SeeedDocument/Seeeduino_LoRa/img/hardware_overview_2.png

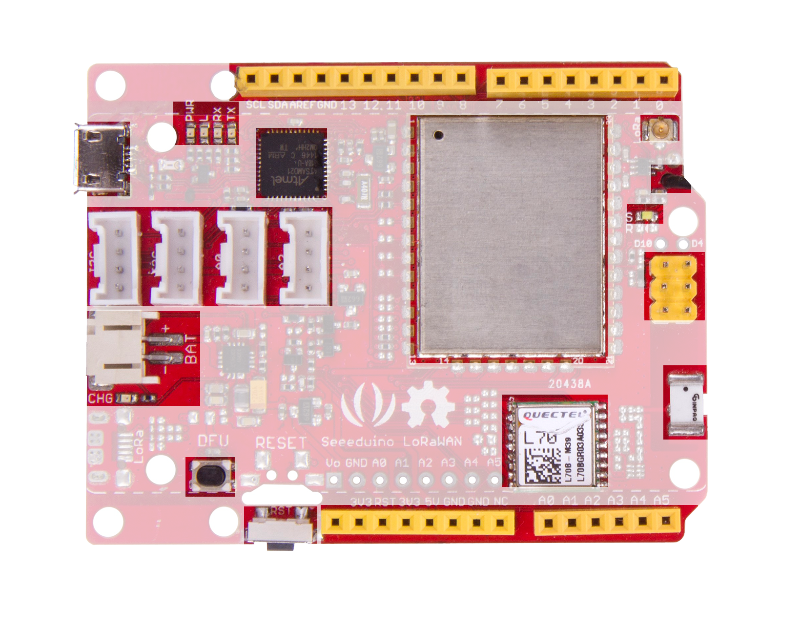
img/hardware_overview_2.png
