SeeedDocument/Seeeduino_LoRa/img/hardware_overview_1.png

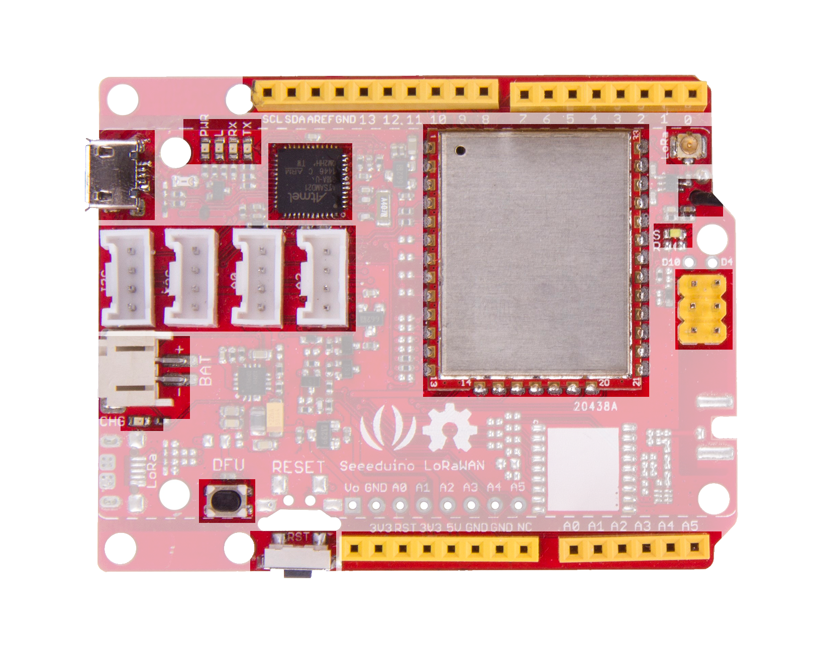
img/hardware_overview_1.png
