SeeedDocument/Seeeduino_LoRa/res/Seeeduino LoRaWAN GPS.pdf

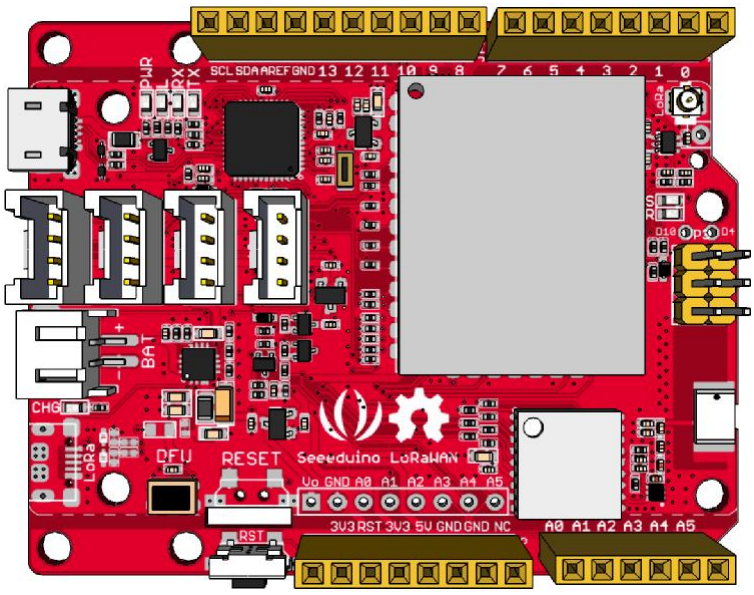
[picture p6: figure]
