SeeedDocument/Seeeduino_LoRa/img/11r.jpg

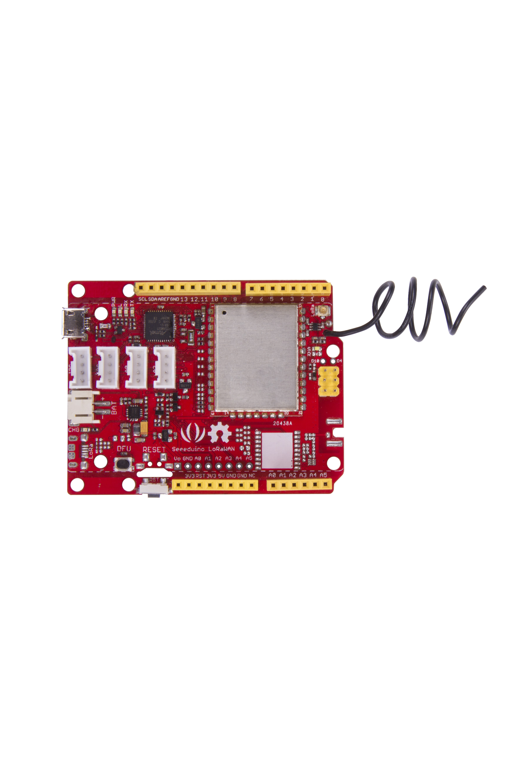
img/11r.jpg
