SeeedDocument/Seeeduino_LoRa/img/arduino.png

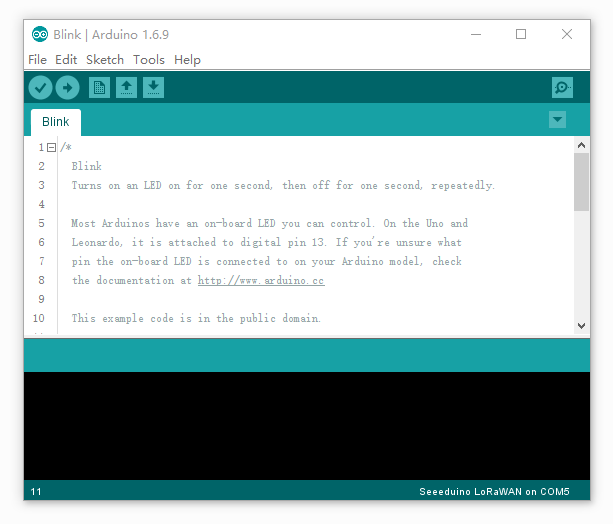
img/arduino.png
