SeeedDocument/Seeeduino_LoRa/img/blink1.png

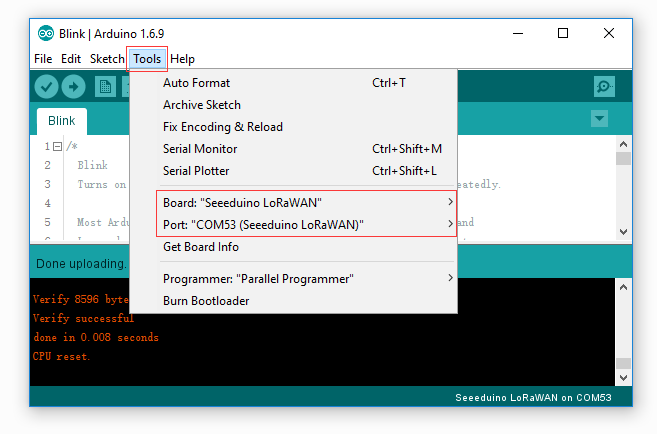
img/blink1.png
