SeeedDocument/Seeeduino_LoRa/img/blink2.png

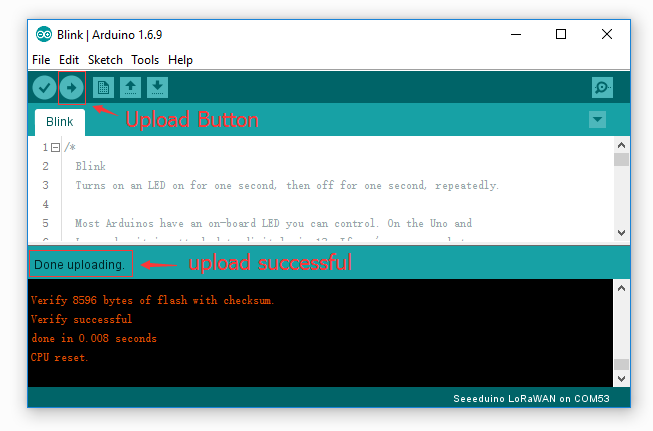
img/blink2.png
