SeeedDocument/Seeeduino_LoRa/img/blink3.png

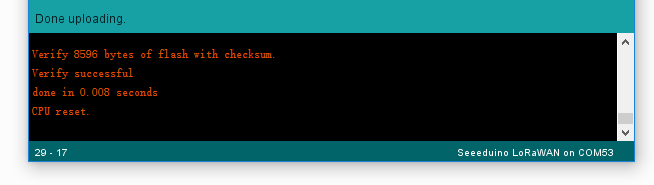
img/blink3.png
