SeeedDocument/Seeeduino_LoRa/img/boards_manager.png

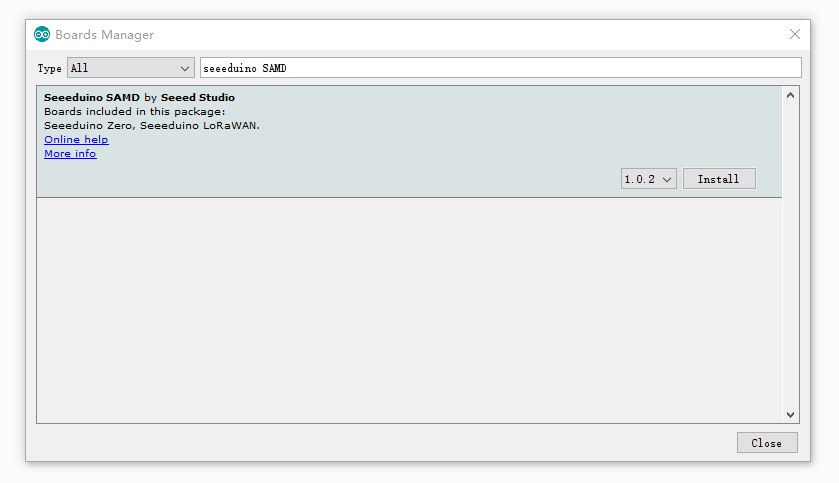
img/boards_manager.png
