SeeedDocument/Seeeduino_LoRa/img/device_manager.png

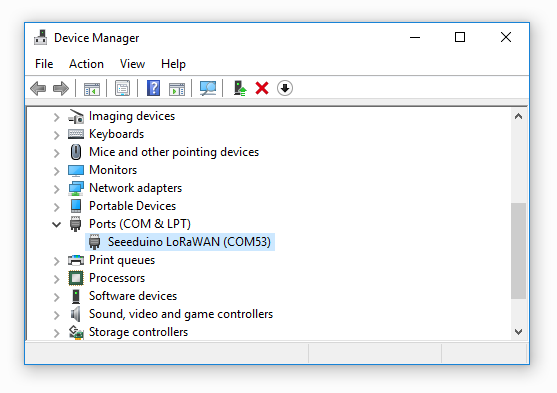
img/device_manager.png
