SeeedDocument/Seeeduino_LoRa/img/firmware_1.png

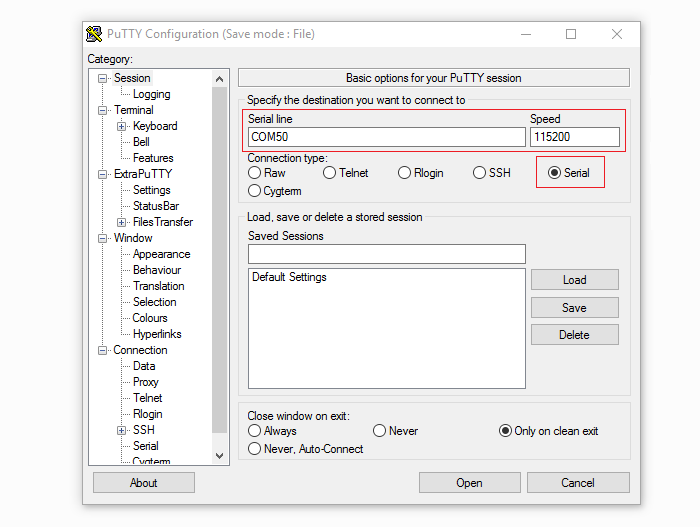
img/firmware_1.png
