SeeedDocument/Seeeduino_LoRa/img/firmware_2.png

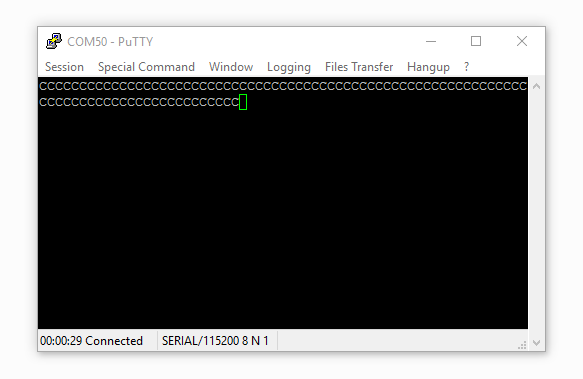
img/firmware_2.png
