SeeedDocument/Seeeduino_LoRa/img/firmware_3.png

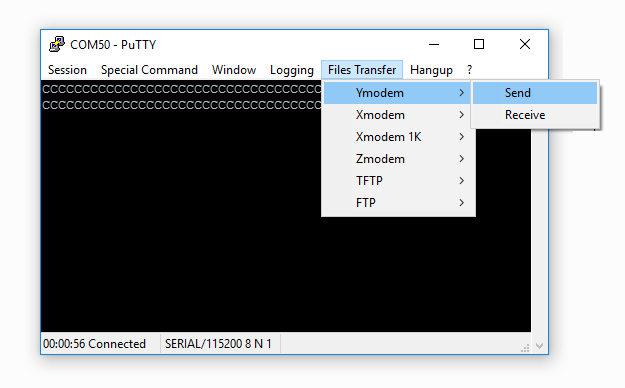
img/firmware_3.png
