SeeedDocument/Seeeduino_LoRa/img/firmware_4.png

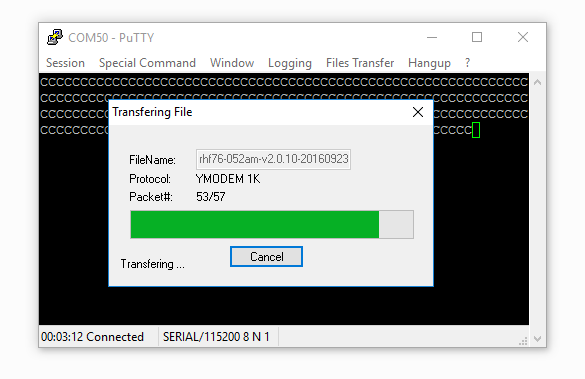
img/firmware_4.png
