SeeedDocument/Seeeduino_LoRa/img/gps.png

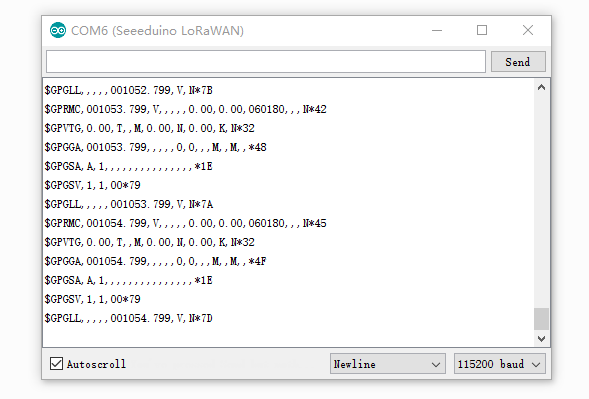
img/gps.png
