SeeedDocument/Seeeduino_LoRa/img/gps_hw0.png

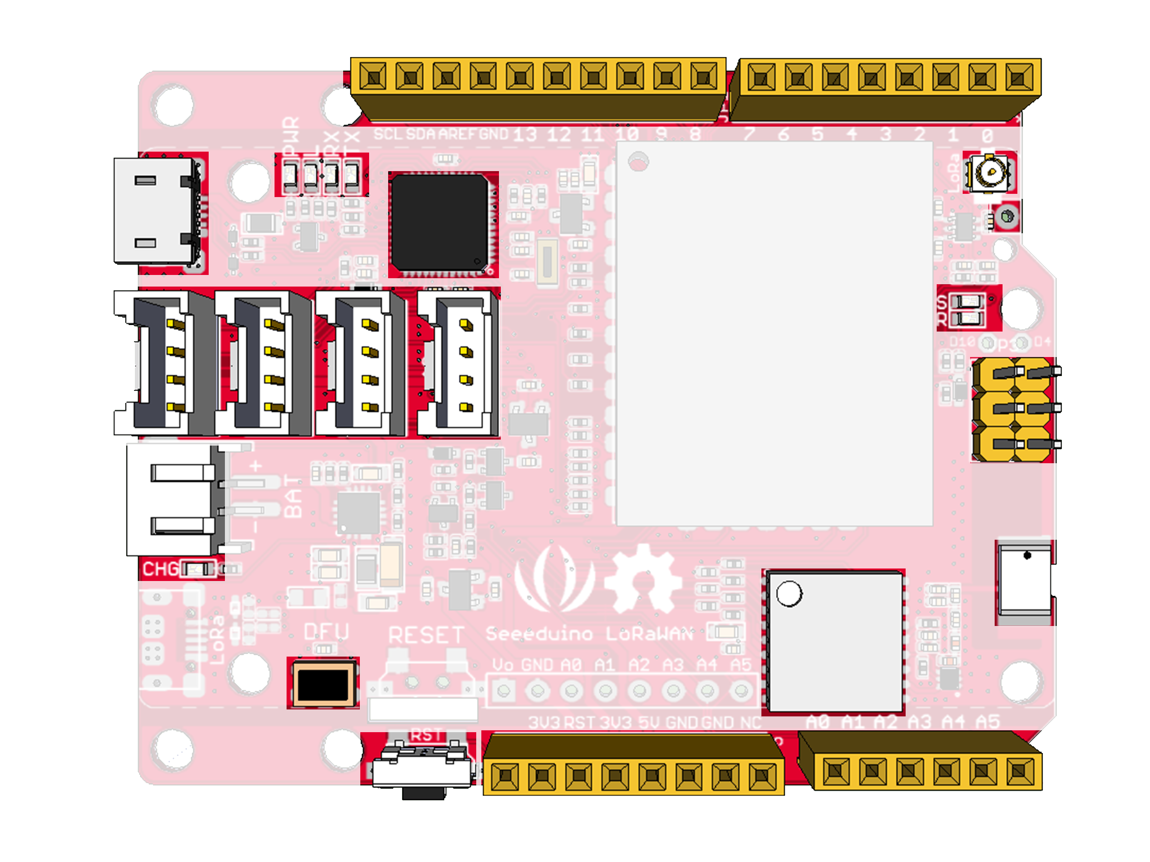
img/gps_hw0.png
