SeeedDocument/Seeeduino_LoRa/img/hw_0.png

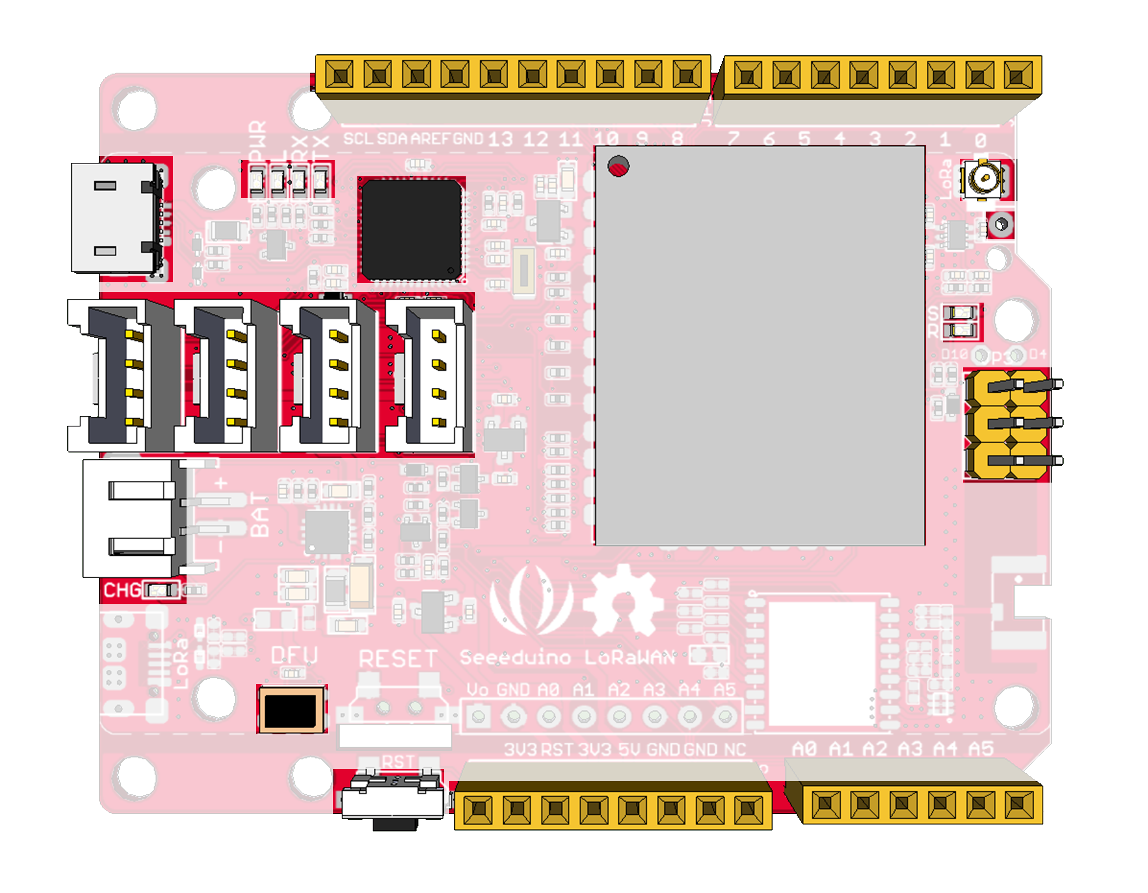
img/hw_0.png
