SeeedDocument/Seeeduino_LoRa/img/monitor_rx.png

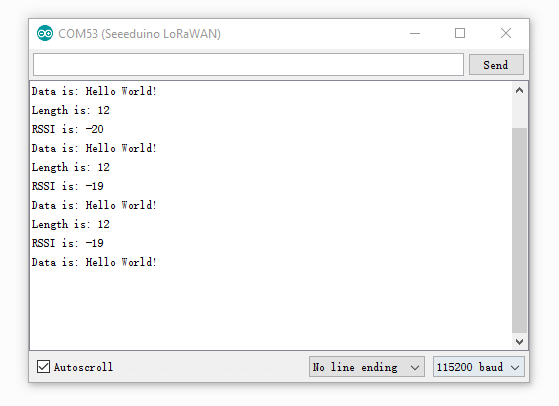
img/monitor_rx.png
