SeeedDocument/Seeeduino_LoRa/img/pin_map.png

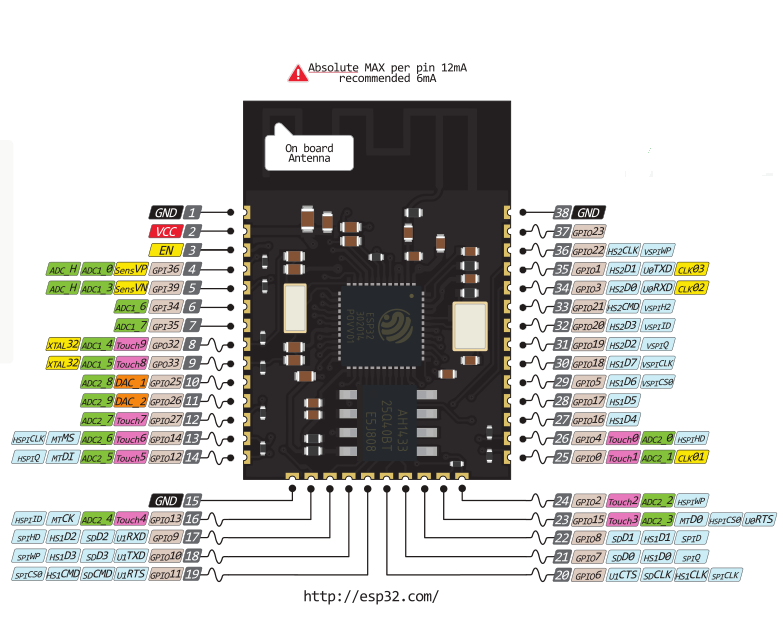
img/pin_map.png
