SeeedDocument/Seeeduino_LoRa/img/VER.png

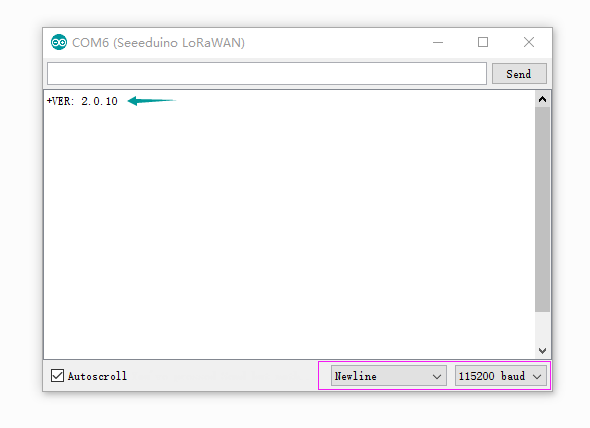
img/VER.png
