SeeedDocument/Seeeduino_LoRa/img/arduino_setup.png

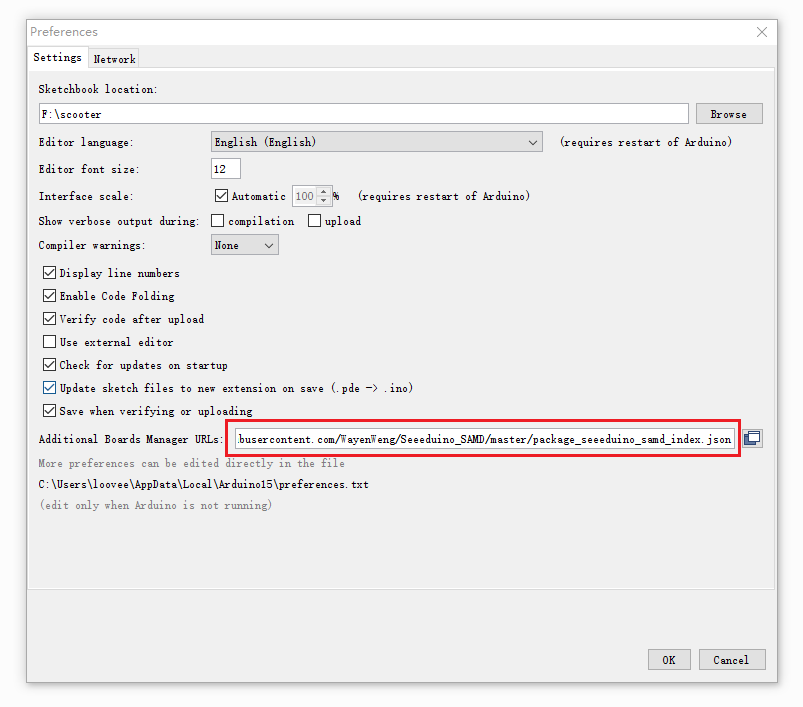
img/arduino_setup.png
