SeeedDocument/Seeeduino_LoRa/res/Seeeduino LoRaWAN GPS_top.pdf

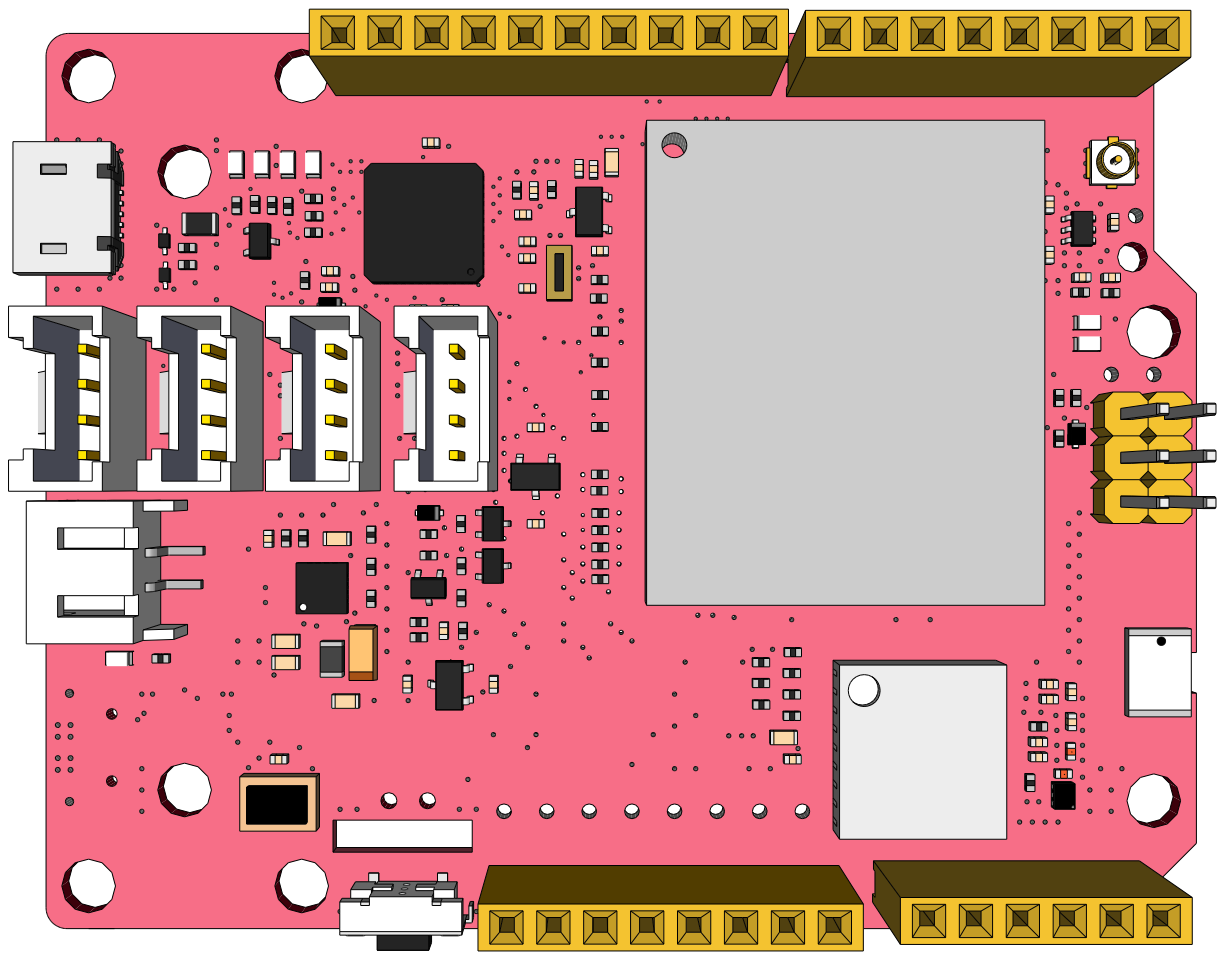
[picture p25: page 1]
