SeeedDocument/Seeeduino_LoRa/res/202001246 Seeeduino LoRaWAN 原理图/Seeeduino LoRaWan.brd

## EAGLE design res/202001246 Seeeduino LoRaWAN 原理图/Seeeduino LoRaWan.brd (2016-11-03)

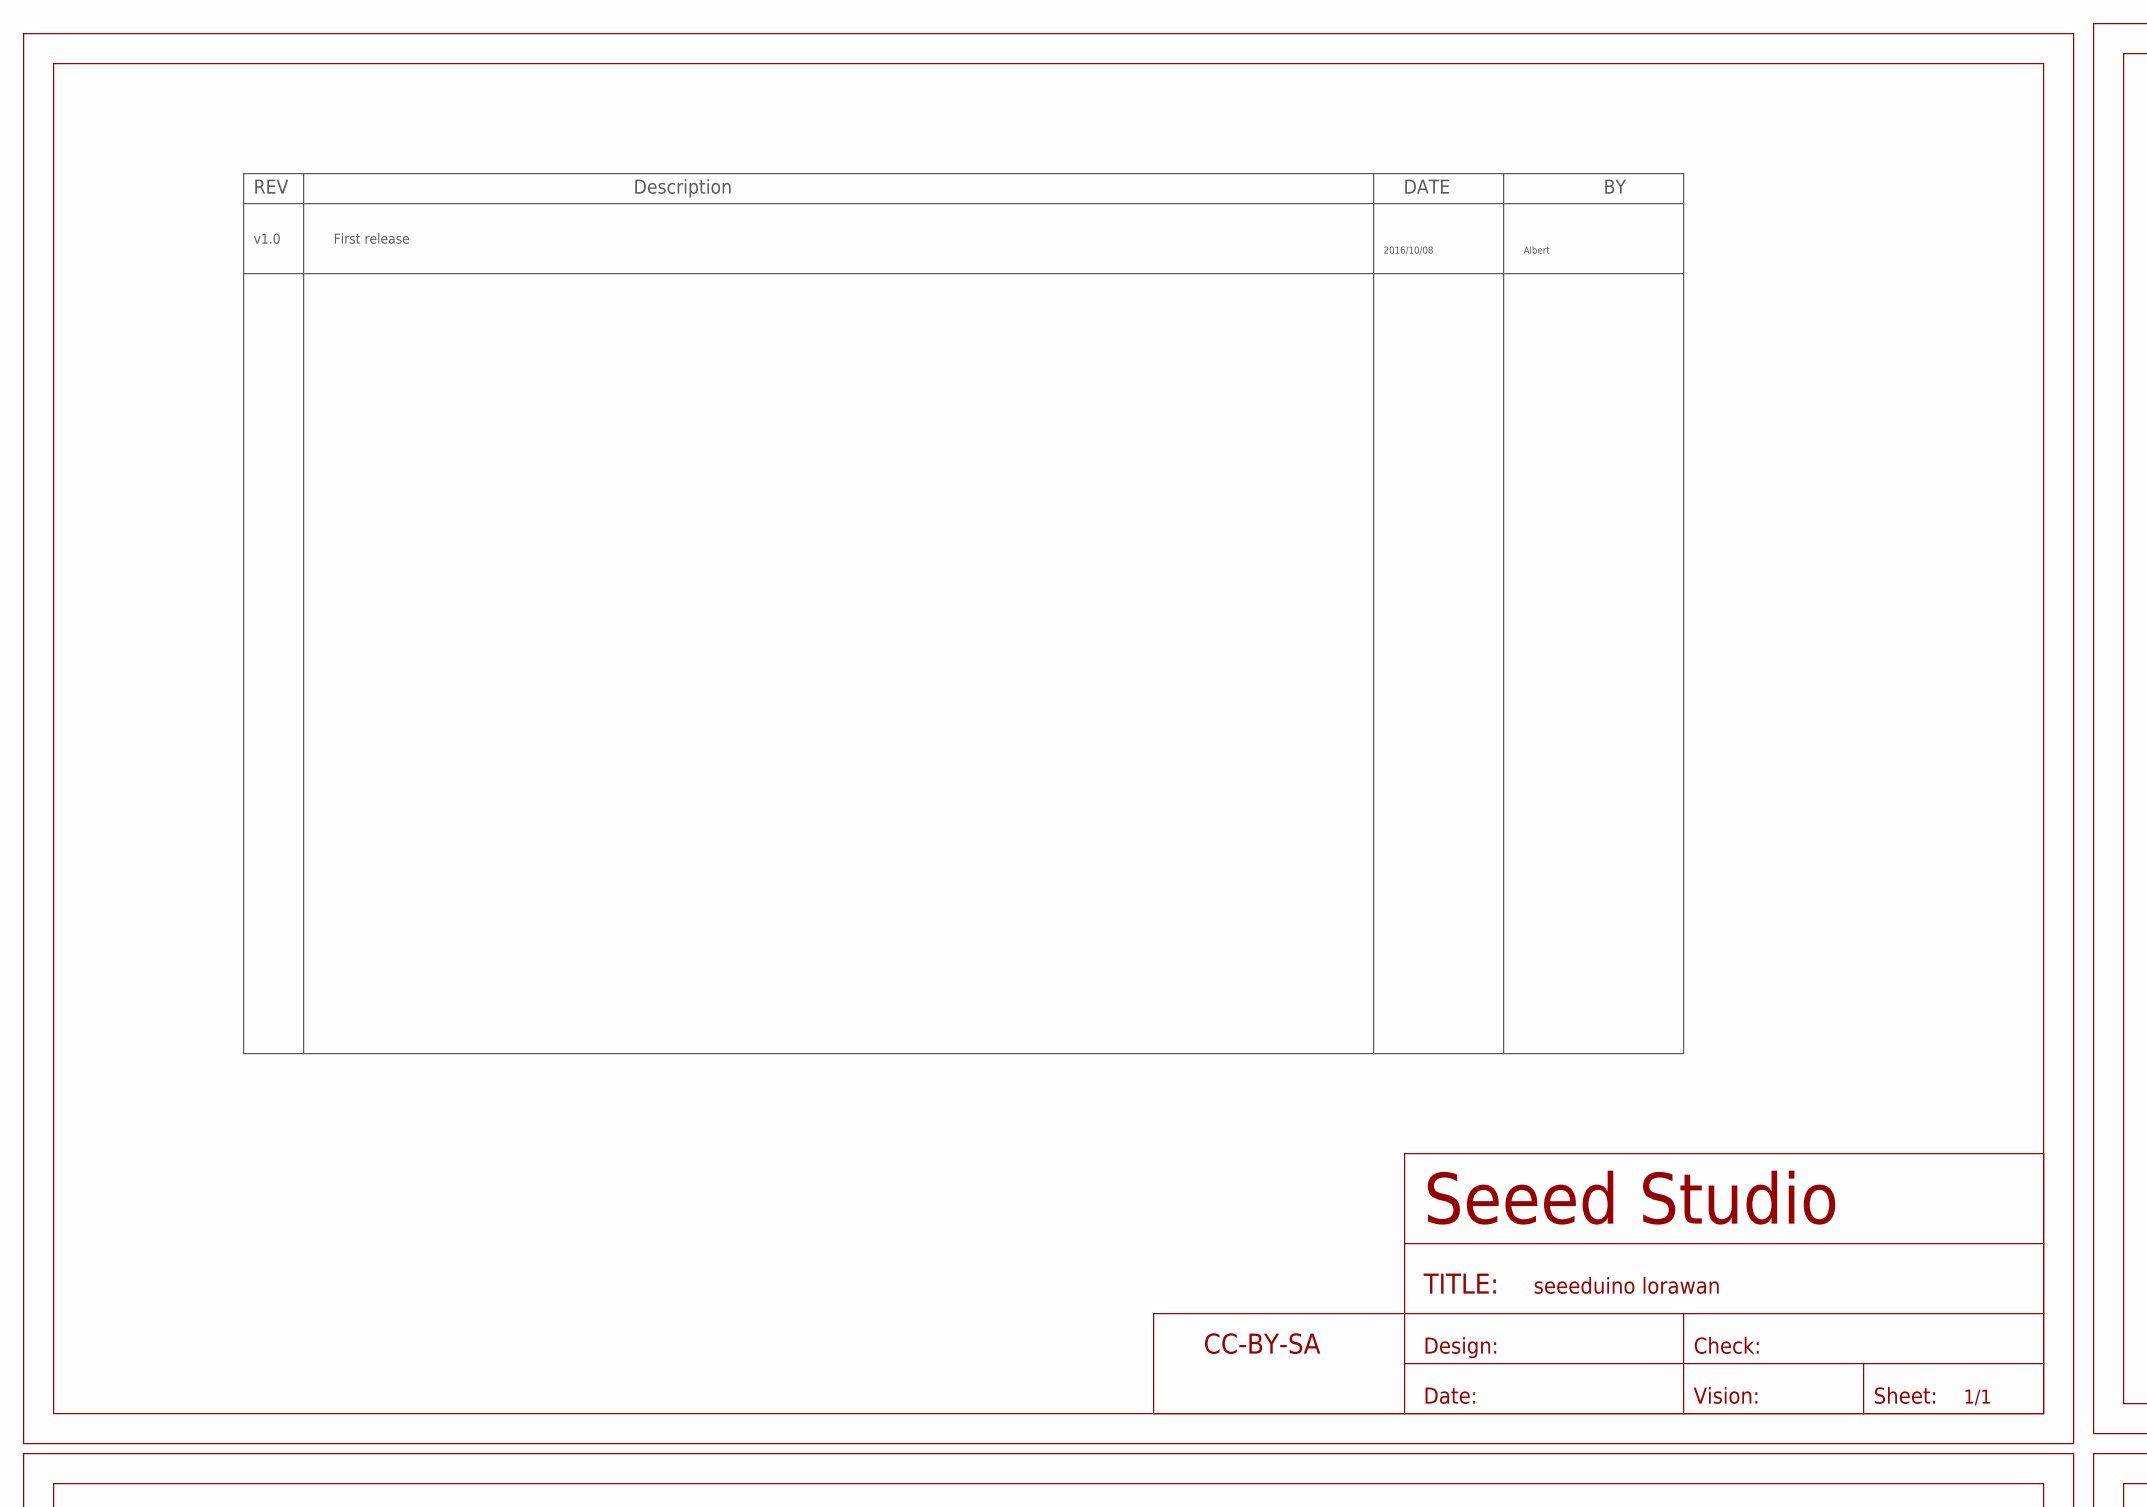
[picture p26: schematic Seeeduino LoRaWan.sch, part in row 1, column 1]

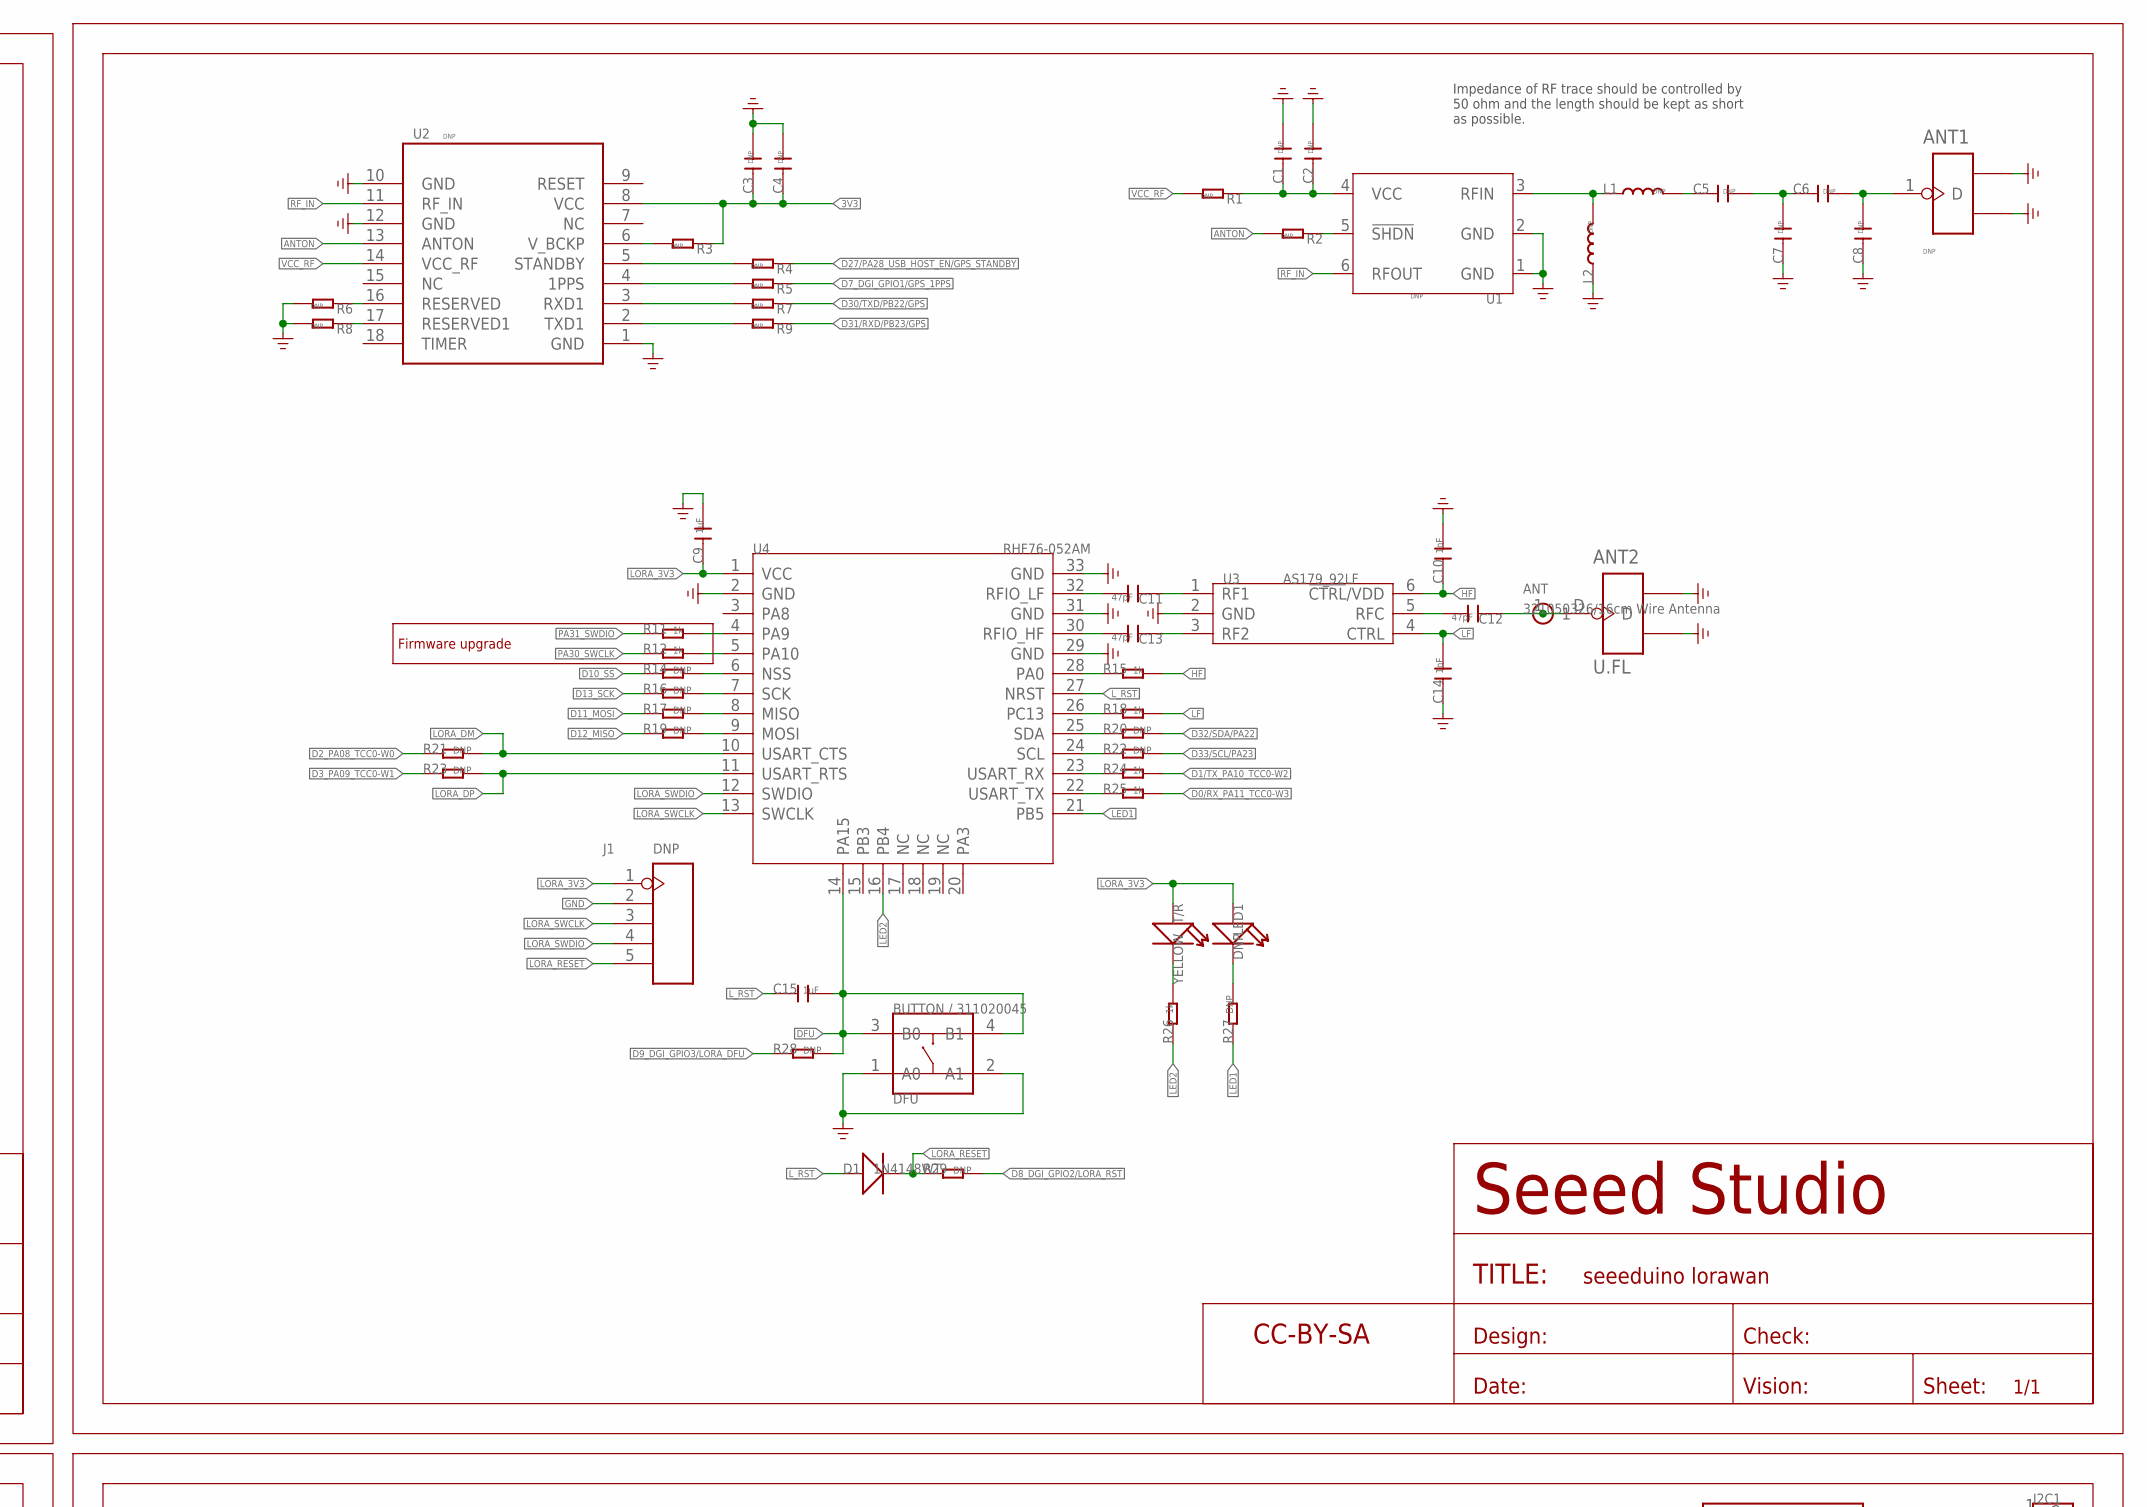
[picture p27: schematic Seeeduino LoRaWan.sch, part in row 1, column 2]

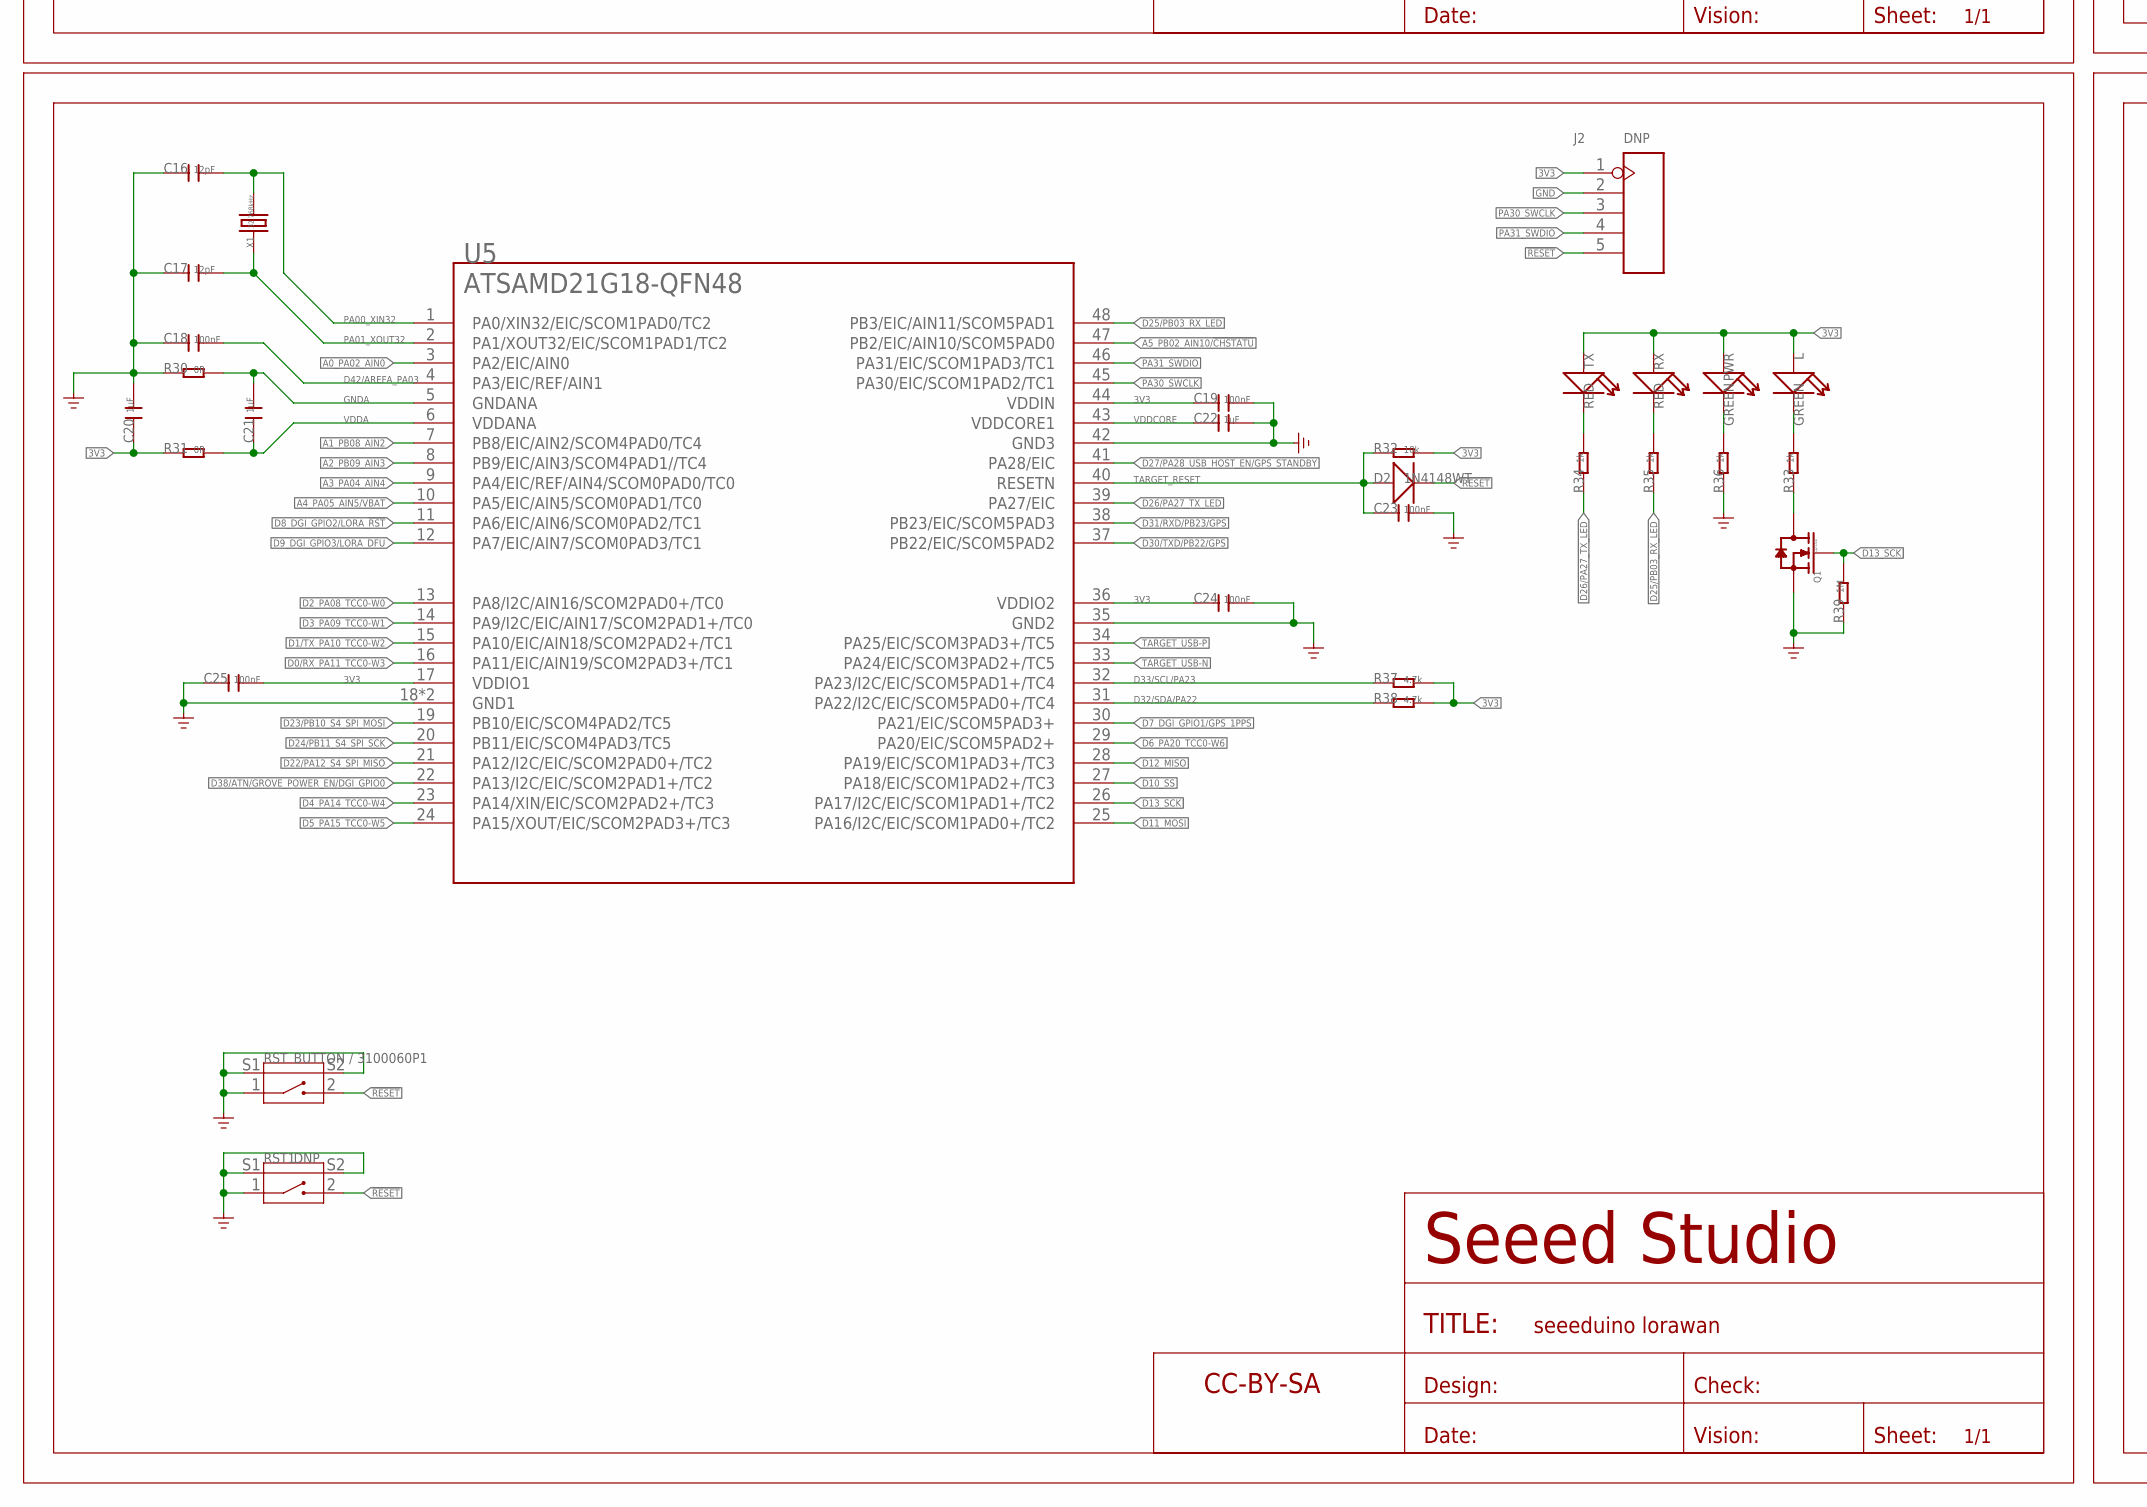
[picture p28: schematic Seeeduino LoRaWan.sch, part in row 2, column 1]

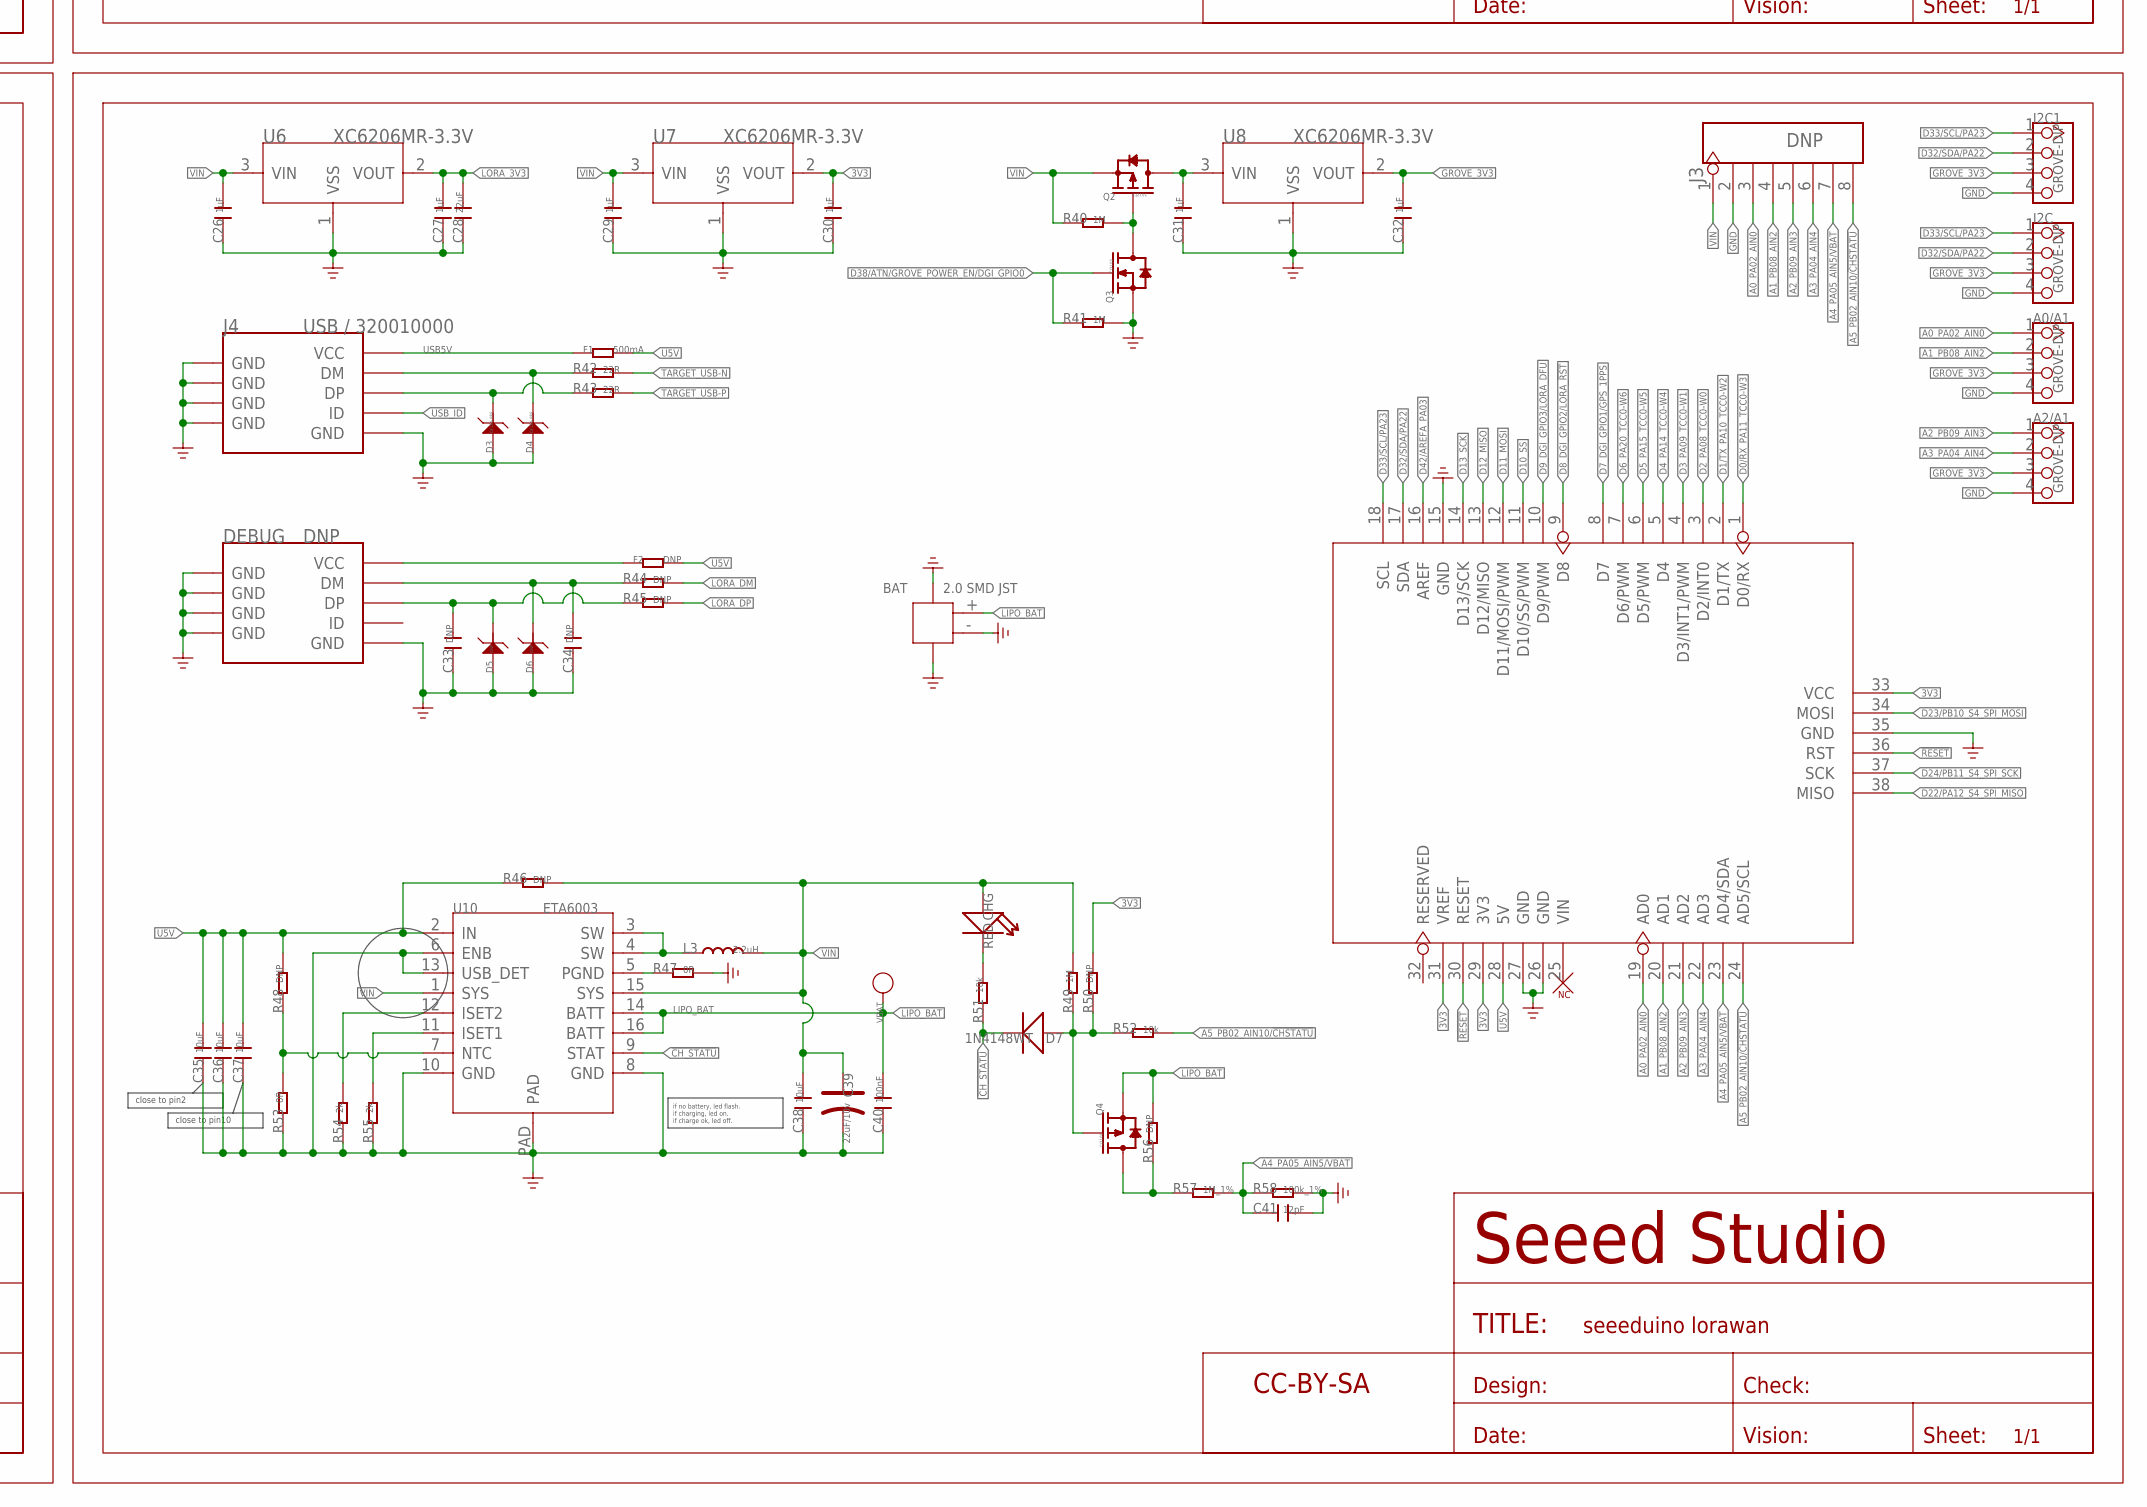
[picture p29: schematic Seeeduino LoRaWan.sch, part in row 2, column 2]

Parts:
A0/A1, A2/A1: GROVE-DIP; 4P-2.0
ANT: 321050326/16cm Wire Antenna; 1P-65/35MIL
ANT1: DNP; ANT3-SMD-5.2X3.7X0.7MM
ANT2: U.FL; U-FL3P-SMD-2.6X2.6X1.0MM
BAT: 2.0 SMD JST; HW2-SMD-2.0-90D
C1, C2, C3, C5, C6, C7, C8, C33, C34: DNP; C0402
C4: DNP; C0603
C9, C15, C20, C21, C22, C26, C27, C29, C30, C31, C32: 1uF; C0402
C10, C14: 1nF; C0402
C11, C12, C13: 47pF; C0402
C16, C17, C41: 12pF; C0402
C18, C19, C23, C24, C25, C40: 100nF; C0402
C28: 22uF; C0603
C35, C36, C37, C38: 10uF; C0603
C39: 22uF/10v; AVX-A
CHG: RED; LED-0603
D1, D2, D7: 1N4148WT; SOD523
D3, D4: DF2S6.8FS; SOD-923
D5, D6: DNP; SOD-923
DEBUG: DNP; MICRO-USB
DFU: BUTTON / 311020045; SW4P-SMD-4.5X3.2X2.5MM
F1: 500mA; R0805
F2: DNP; R0805
FR, FR1: PAGE1; SEEEDSTUDIO-PCB-FRAME
I2C, I2C1: GROVE-DIP; 4P-2.0
J1, J2: DNP; H5-SMD-2.0-TEST
J3: DNP; 8P-2.54-65/35MIL
J4: USB / 320010000; MICRO-USB
L: GREEN; LED-0603
L1, L2: DNP; L0402
L3: 2.2uH; L0805
LED1: DNP; LED-0603
PWR: GREEN; LED-0603
Q1, Q3: CJ2102; SOT-323
Q2, Q4: CJ2101; SOT323
R1, R2, R3, R4, R5, R6, R7, R8, R9, R14, R16, R17, R19, R20, R21, R22, R23, R27, R28, R29, R44, R45, R46, R48, R50, R56: DNP; R0402
R11, R12, R15, R18, R24, R25, R26, R33, R34, R35, R36: 1k; R0402
R30, R31, R47, R53: 0R; R0402
R32, R51, R52: 10k; R0402
R37, R38: 4.7k; R0402
R39, R40, R41, R49: 1M; R0402
R42, R43: 22R; R0402
R54, R55: 2k; R0402
R57: 1M_1%; R0402
R58: 100k_1%; R0402
RST: BUTTON / 3100060P1; 4P-SMD-7.0X3.5X3.5H-90D
RST1: DNP; 4P-SMD-7.0X3.5X3.5H-90D
RX: RED; LED-0603
T/R: YELLOW; LED-0603
TX: RED; LED-0603
U1: DNP; DFN6-0.5-1.5X1.2X0.72MM
U2: DNP; LGA18-1.1-9.7X10.1X2.5MM
U3: AS179_92LF; SC-70
U4: RHF76-052AM; MODULE33P-SMD-2.0-28X23X2.9MM
U5: ATSAMD21G18-QFN48; QFN48-7X7
U6, U7, U8: XC6206MR-3.3V; SOT23
U9: ARDUINO-38P
U10: ETA6003; QFN16G-0.5-3X3MM
U$2, U$3: SEEEDSTUDIO-OPEN-SCH-FRAME; SEEEDSTUDIO-PCB-FRAME
VBAT: DNP; TP_4545
X1: 32.768kHz; X2-SMD-3.2X1.5X0.55MM

Connections:
3V3: C3.1, C4.1, C19.1, C20.1, C24.1, C25.2, C30.2, J2.1, L.+, PWR.+, R3.1, R31.1, R32.2, R37.2, R38.2, R50.2, RX.+, TX.+, U2.8 (VCC), U5.17 (VDDIO1), U5.36 (VDDIO2), U5.44 (VDDIN), U7.2 (VOUT), U9.29 (3V3), U9.31 (VREF), U9.33 (VCC)
!CH_STATU: D7.-, R51.1, U10.9 (STAT)
!RESET: D2.-, J2.5, RST.2, RST1.2, U9.30 (RESET), U9.36 (RST)
A0_PA02_AIN0: A0/A1.1, J3.3, U5.3 (PA2/EIC/AIN0), U9.19 (AD0)
A1_PB08_AIN2: A0/A1.2, J3.4, U5.7 (PB8/EIC/AIN2/SCOM4PAD0/TC4), U9.20 (AD1)
A2_PB09_AIN3: A2/A1.1, J3.5, U5.8 (PB9/EIC/AIN3/SCOM4PAD1//TC4), U9.21 (AD2)
A3_PA04_AIN4: A2/A1.2, J3.6, U5.9 (PA4/EIC/REF/AIN4/SCOM0PAD0/TC0), U9.22 (AD3)
A4_PA05_AIN5/VBAT: C41.1, J3.7, R57.2, R58.1, U5.10 (PA5/EIC/AIN5/SCOM0PAD1/TC0), U9.23 (AD4/SDA)
A5_PB02_AIN10/!CHSTATU: J3.8, R52.2, U5.47 (PB2/EIC/AIN10/SCOM5PAD0), U9.24 (AD5/SCL)
ANTON: R2.2, U2.13 (ANTON)
D0/RX_PA11_TCC0-W3: R25.2, U5.16 (PA11/EIC/AIN19/SCOM2PAD3+/TC1), U9.1 (D0/RX)
D1/TX_PA10_TCC0-W2: R24.2, U5.15 (PA10/EIC/AIN18/SCOM2PAD2+/TC1), U9.2 (D1/TX)
D2_PA08_TCC0-W0: R21.1, U5.13 (PA8/I2C/AIN16/SCOM2PAD0+/TC0), U9.3 (D2/INT0)
D3_PA09_TCC0-W1: R23.1, U5.14 (PA9/I2C/EIC/AIN17/SCOM2PAD1+/TC0), U9.4 (D3/INT1/PWM)
D4_PA14_TCC0-W4: U5.23 (PA14/XIN/EIC/SCOM2PAD2+/TC3), U9.5 (D4)
D5_PA15_TCC0-W5: U5.24 (PA15/XOUT/EIC/SCOM2PAD3+/TC3), U9.6 (D5/PWM)
D6_PA20_TCC0-W6: U5.29 (PA20/EIC/SCOM5PAD2+), U9.7 (D6/PWM)
D7_DGI_GPIO1/GPS_1PPS: R5.1, U5.30 (PA21/EIC/SCOM5PAD3+), U9.8 (D7)
D8_DGI_GPIO2/LORA_!RST: R29.2, U5.11 (PA6/EIC/AIN6/SCOM0PAD2/TC1), U9.9 (D8)
D9_DGI_GPIO3/LORA_DFU: R28.1, U5.12 (PA7/EIC/AIN7/SCOM0PAD3/TC1), U9.10 (D9/PWM)
D10_SS: R14.1, U5.27 (PA18/EIC/SCOM1PAD2+/TC3), U9.11 (D10/SS/PWM)
D11_MOSI: R17.1, U5.25 (PA16/I2C/EIC/SCOM1PAD0+/TC2), U9.12 (D11/MOSI/PWM)
D12_MISO: R19.1, U5.28 (PA19/EIC/SCOM1PAD3+/TC3), U9.13 (D12/MISO)
D13_SCK: Q1.1 (G), R16.1, R39.2, U5.26 (PA17/I2C/EIC/SCOM1PAD1+/TC2), U9.14 (D13/SCK)
D22/PA12_S4_SPI_MISO: U5.21 (PA12/I2C/EIC/SCOM2PAD0+/TC2), U9.38 (MISO)
D23/PB10_S4_SPI_MOSI: U5.19 (PB10/EIC/SCOM4PAD2/TC5), U9.34 (MOSI)
D24/PB11_S4_SPI_SCK: U5.20 (PB11/EIC/SCOM4PAD3/TC5), U9.37 (SCK)
D25/PB03_RX_LED: R35.1, U5.48 (PB3/EIC/AIN11/SCOM5PAD1)
D26/PA27_TX_LED: R34.1, U5.39 (PA27/EIC)
D27/PA28_USB_HOST_EN/GPS_STANDBY: R4.1, U5.41 (PA28/EIC)
D30/TXD/PB22/GPS: R7.1, U5.37 (PB22/EIC/SCOM5PAD2)
D31/RXD/PB23/GPS: R9.1, U5.38 (PB23/EIC/SCOM5PAD3)
D32/SDA/PA22: I2C.2, I2C1.2, R20.2, R38.1, U5.31 (PA22/I2C/EIC/SCOM5PAD0+/TC4), U9.17 (SDA)
D33/SCL/PA23: I2C.1, I2C1.1, R22.2, R37.1, U5.32 (PA23/I2C/EIC/SCOM5PAD1+/TC4), U9.18 (SCL)
D38/ATN/GROVE_POWER_EN/DGI_GPIO0: Q3.1 (G), R41.1, U5.22 (PA13/I2C/EIC/SCOM2PAD1+/TC2)
D42/AREFA_PA03: C18.2, U5.4 (PA3/EIC/REF/AIN1), U9.16 (AREF)
DFU: C15.2, DFU.3 (B0), DFU.4 (B1), R28.2, U4.14 (PA15)
GND: A0/A1.4, A2/A1.4, ANT1.2 (GND1), ANT1.3 (GND2), ANT2.GND1, ANT2.GND2, BAT.3, BAT.4, BAT.- (2), C1.2, C2.2, C3.2, C4.2, C7.1, C8.1, C9.2, C10.2, C14.1, C16.1, C17.1, C18.1, C19.2, C20.2, C22.2, C23.2, C24.2, C25.1, C26.1, C27.1, C28.1, C29.1, C30.1, C31.1, C32.1, C33.1, C34.1, C35.1, C36.1, C37.1, C38.1, C39.-, C40.1, C41.2, D3.2 (1), D4.2 (1), D5.2 (1), D6.2 (1), DEBUG.5 (GND), DEBUG.S1 (GND), DEBUG.S2 (GND), DEBUG.S3 (GND), DEBUG.S4 (GND), DEBUG.S5 (GND), DEBUG.S6 (GND), DFU.1 (A0), DFU.2 (A1), I2C.4, I2C1.4, J1.2, J2.2, J3.2, J4.5 (GND), J4.S1 (GND), J4.S2 (GND), J4.S3 (GND), J4.S4 (GND), J4.S5 (GND), J4.S6 (GND), L2.1, Q1.2 (S), Q3.2 (S), R6.2, R8.2, R30.1, R36.1, R39.1, R41.2, R47.2, R53.1, R54.1, R55.1, R58.2, RST.1, RST.S1, RST.S2, RST1.1, RST1.S1, RST1.S2, U1.1 (GND), U1.2 (GND), U2.1 (GND), U2.10 (GND), U2.12 (GND), U3.2 (GND), U4.2 (GND), U4.29 (GND), U4.31 (GND), U4.33 (GND), U5.18 (GND1), U5.35 (GND2), U5.42 (GND3), U5.PAD (GND1), U6.1 (VSS), U7.1 (VSS), U8.1 (VSS), U9.15 (GND), U9.26 (GND), U9.27 (GND), U9.35 (GND), U10.6 (ENB), U10.8 (GND), U10.10 (GND), U10.13 (USB_DET), U10.PAD
GNDA: C21.2, R30.2, U5.5 (GNDANA)
GROVE_3V3: A0/A1.3, A2/A1.3, C32.2, I2C.3, I2C1.3, U8.2 (VOUT)
HF: C10.1, R15.2, U3.6 (!CTRL!/VDD)
LED1: R27.1, U4.21 (PB5)
LED2: R26.1, U4.16 (PB4)
LF: C14.2, R18.2, U3.4 (CTRL)
LIPO_BAT: BAT.+ (1), C40.2, Q4.2 (S), R56.2, U10.14 (BATT), U10.16 (BATT), VBAT.T
LORA_3V3: C9.1, C27.2, C28.2, J1.1, LED1.+, T/R.+, U4.1 (VCC), U6.2 (VOUT)
LORA_!RESET: D1.-, J1.5, R29.1
LORA_DM: R21.2, R44.2, U4.10 (USART_CTS)
LORA_DP: R23.2, R45.2, U4.11 (USART_RTS)
LORA_SWCLK: J1.3, U4.13 (SWCLK)
LORA_SWDIO: J1.4, U4.12 (SWDIO)
L_RST: C15.1, D1.+, U4.27 (NRST)
unnamed: Q1.3 (D), R33.1
unnamed: R34.2, TX.-
unnamed: C5.2, C6.1, C7.2
unnamed: R35.2, RX.-
unnamed: L.-, R33.2
unnamed: ANT1.1 (D), C6.2, C8.2
unnamed: D3.1 (2), J4.3 (DP), R43.1
unnamed: L1.1, L2.2, U1.3 (RFIN)
unnamed: C33.2, D5.1 (2), DEBUG.3 (DP), R45.1
unnamed: D4.1 (2), J4.2 (DM), R42.1
unnamed: C5.1, L1.2
unnamed: PWR.-, R36.2
unnamed: R2.1, U1.5 (!SHDN)
unnamed: C1.1, C2.1, R1.1, U1.4 (VCC)
unnamed: DEBUG.1 (VCC), F2.1
unnamed: R6.1, U2.16 (RESERVED)
unnamed: R8.1, U2.17 (RESERVED1)
unnamed: R3.2, U2.6 (V_BCKP)
unnamed: R4.2, U2.5 (STANDBY)
unnamed: R5.2, U2.4 (1PPS)
unnamed: R48.1, R53.2, U10.7 (NTC)
unnamed: R55.2, U10.11 (ISET1)
unnamed: C34.2, D6.1 (2), DEBUG.2 (DM), R44.1
unnamed: C12.2, U3.5 (RFC)
unnamed: C11.2, U4.32 (RFIO_LF)
unnamed: C13.2, U4.30 (RFIO_HF)
unnamed: R54.2, U10.12 (ISET2)
unnamed: R24.1, U4.23 (USART_RX)
unnamed: R47.1, U10.5 (PGND)
unnamed: R25.1, U4.22 (USART_TX)
unnamed: R11.2, U4.4 (PA9)
unnamed: R12.2, U4.5 (PA10)
unnamed: CHG.-, R51.2
unnamed: Q4.3 (D), R56.1, R57.1
unnamed: R20.1, U4.25 (SDA)
unnamed: R22.1, U4.24 (SCL)
unnamed: R19.2, U4.9 (MOSI)
unnamed: R17.2, U4.8 (MISO)
unnamed: R16.2, U4.7 (SCK)
unnamed: R14.2, U4.6 (NSS)
unnamed: C31.2, Q2.3 (D), U8.3 (VIN)
unnamed: R26.2, T/R.-
unnamed: LED1.-, R27.2
unnamed: R15.1, U4.28 (PA0)
unnamed: R18.1, U4.26 (PC13)
unnamed: Q2.1 (G), Q3.3 (D), R40.2
unnamed: D7.+, Q4.1 (G), R49.1, R50.1, R52.1
unnamed: C11.1, U3.1 (RF1)
unnamed: C13.1, U3.3 (RF2)
unnamed: ANT.1, ANT2.D, C12.1
unnamed: L3.1, U10.3 (SW), U10.4 (SW)
PA00_XIN32: C16.2, U5.1 (PA0/XIN32/EIC/SCOM1PAD0/TC2), X1.2
PA01_XOUT32: C17.2, U5.2 (PA1/XOUT32/EIC/SCOM1PAD1/TC2), X1.1
PA30_SWCLK: J2.3, R12.1, U5.45 (PA30/EIC/SCOM1PAD2/TC1)
PA31_SWDIO: J2.4, R11.1, U5.46 (PA31/EIC/SCOM1PAD3/TC1)
RF_IN: U1.6 (RFOUT), U2.11 (RF_IN)
RXD1: R7.2, U2.3 (RXD1)
TARGET_RESET: C23.1, D2.+, R32.1, U5.40 (RESETN)
TARGET_USB-N: R42.2, U5.33 (PA24/EIC/SCOM3PAD2+/TC5)
TARGET_USB-P: R43.2, U5.34 (PA25/EIC/SCOM3PAD3+/TC5)
TXD1: R9.2, U2.2 (TXD1)
U5V: C35.2, C36.2, C37.2, F1.2, F2.2, R46.1, R48.2, U9.28 (5V), U10.2 (IN)
USB5V: F1.1, J4.1 (VCC)
USB_ID: J4.4 (ID)
VCC_RF: R1.2, U2.14 (VCC_RF)
VDDA: C21.1, R31.2, U5.6 (VDDANA)
VDDCORE: C22.1, U5.43 (VDDCORE1)
VIN: C26.2, C29.2, C38.2, C39.+, CHG.+, J3.1, L3.2, Q2.2 (S), R40.1, R46.2, R49.2, U6.3 (VIN), U7.3 (VIN), U10.1 (SYS), U10.15 (SYS)

Notes on the sheet:
Impedance of RF trace should be controlled by 50 ohm and the length should be kept as short as possible.
close to pin10
if no battery, led flash. if charging, led on. if charge ok, led off.
close to pin2
Firmware upgrade
v1.0
First release
2016/10/08
Albert

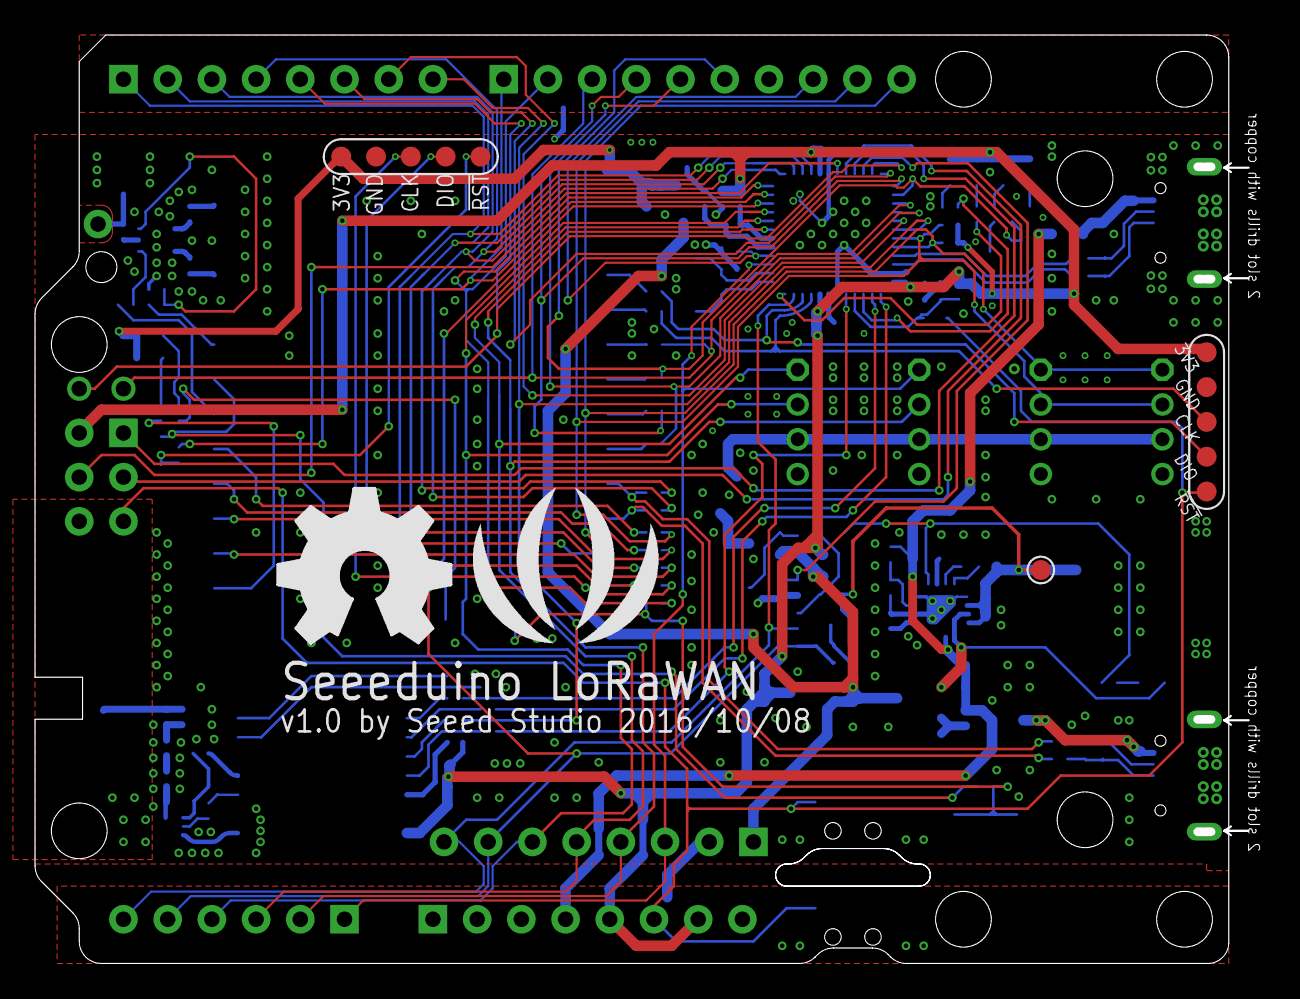
[picture p30: board Seeeduino LoRaWan.brd from above]

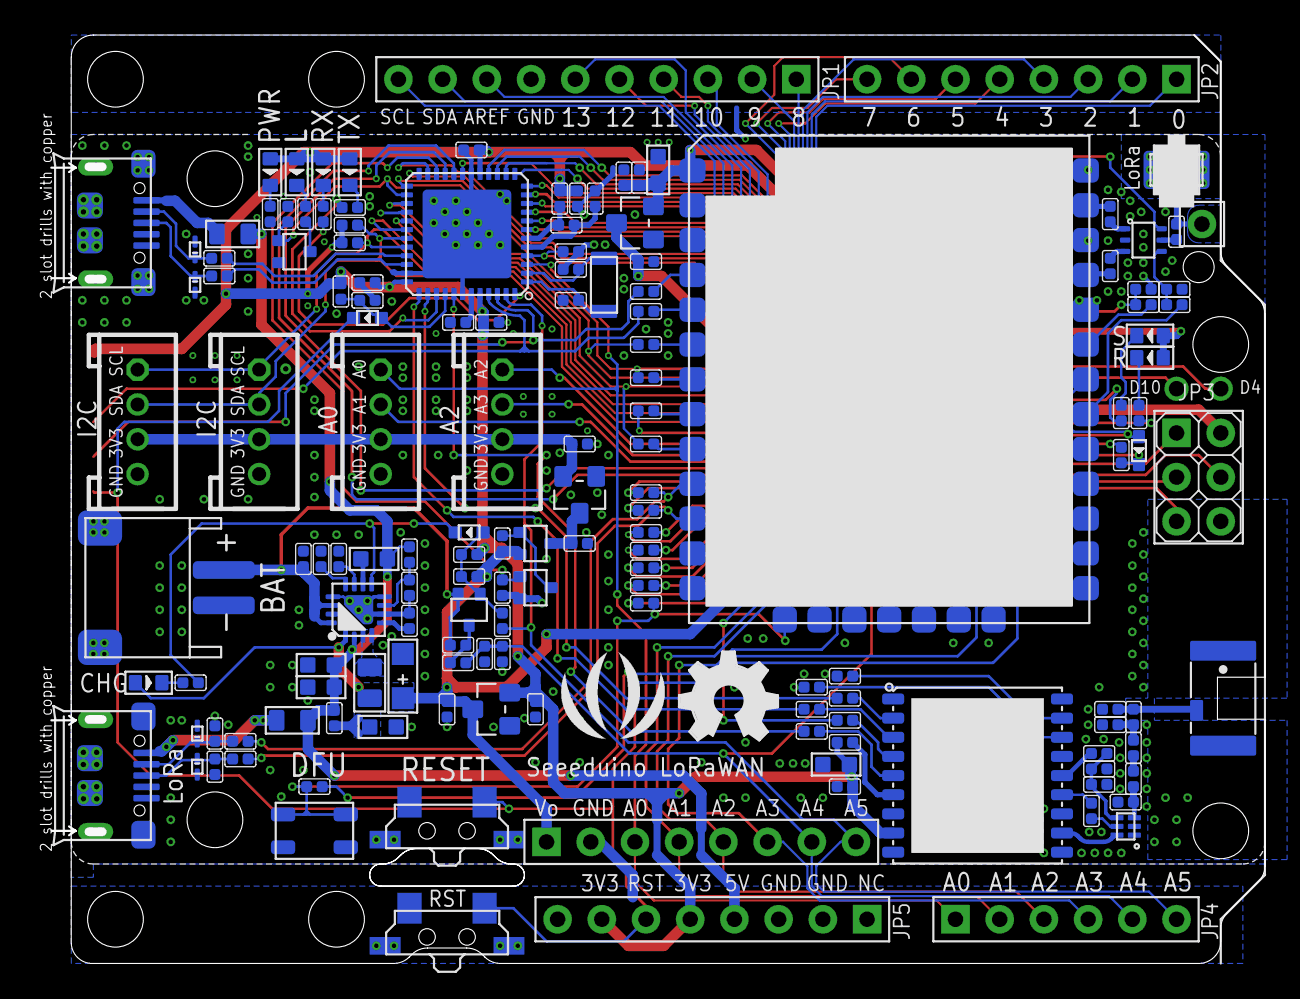
[picture p31: board Seeeduino LoRaWan.brd from below]

Board: 2 copper layers, 69.7 x 53.3 mm, 156 parts (151 on the bottom side), 119 nets.

Other parts of the board:
U$1: OSHW_FILLX350_NOTEXT
U$17: OSHW_FILLX200_NOTEXT_TNAME
U$25: SEEED-SILK-280*268MIL
U$27: SEEED-SILK-420X352
