SeeedDocument/Seeeduino_LoRa/(commit log)

2016-11-01 add board_lora.png
2016-11-01 add device manager
2016-11-01 update device_manager
2016-11-01 add pin map
2016-11-01 update driver
2016-11-03 update images
    [Seeeduino LoRaWan.brd, Seeeduino LoRaWan.sch]
